connornishijima/Lixie_II_OSHW/README.md

Lixie II

# Lixie II Open Hardware
Want to make your own Lixie II? You're in the right place. This repository is a work in progress, but everything you need like the 3D printed base kit, Eagle PCB files or CAD files are here already!
