connornishijima/Lixie_II_OSHW/SOFTWARE/README.md

Software is located in its own repo, for Arduino reasons!

### [Lixie II Arduino Library](https://github.com/connornishijima/Lixie_II)
