connornishijima/Lixie_II_OSHW/3D PRINTING/LIXIE_CAP_SOLID.stl

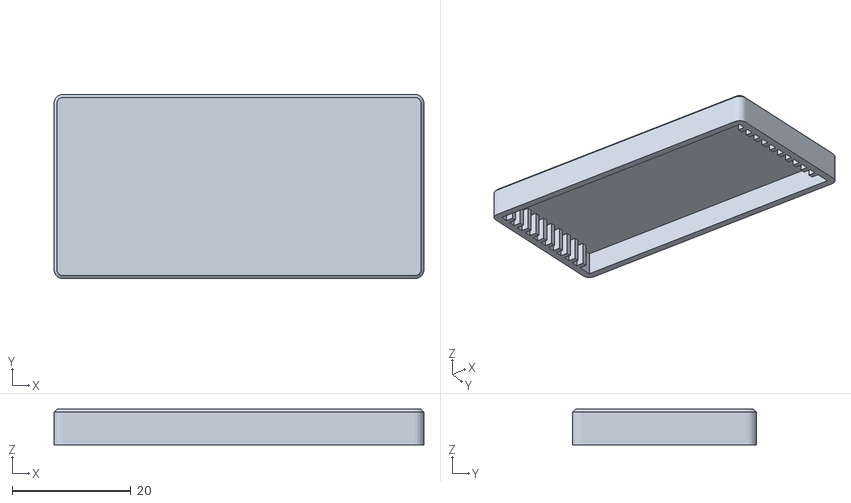
[picture p1: CAD file, 2020-10-05]
3D PRINTING/LIXIE_CAP_SOLID.stl
62.3 x 31.0 x 6.00
