connornishijima/Lixie_II_OSHW/3D PRINTING/LIXIE_II_BASE_LEFT.stl

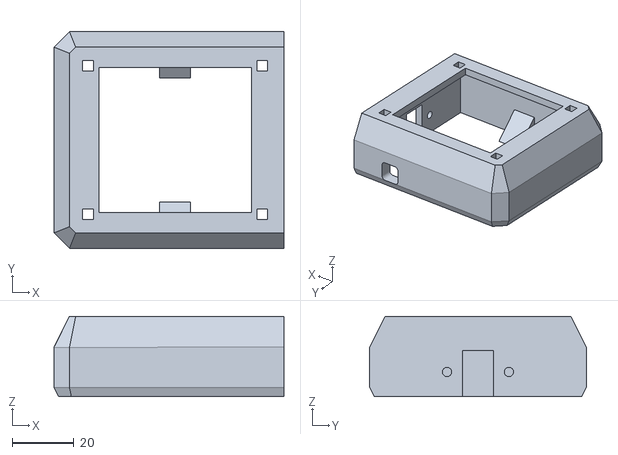
[picture p2: CAD file, 2019-11-22]
3D PRINTING/LIXIE_II_BASE_LEFT.stl
74.3 x 70.0 x 26.0
