connornishijima/Lixie_II_OSHW/3D PRINTING/LIXIE_II_BASE_MIDDLE.stl

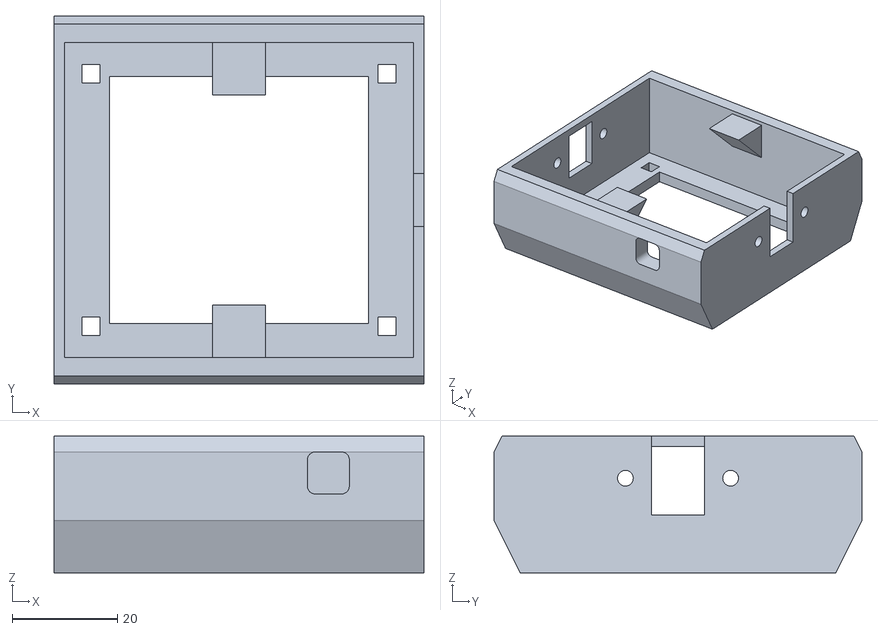
[picture p3: CAD file, 2019-11-22]
3D PRINTING/LIXIE_II_BASE_MIDDLE.stl
70.3 x 70.0 x 26.0
