connornishijima/Lixie_II_OSHW/3D PRINTING/LIXIE_II_BASE_RIGHT_CAP.stl

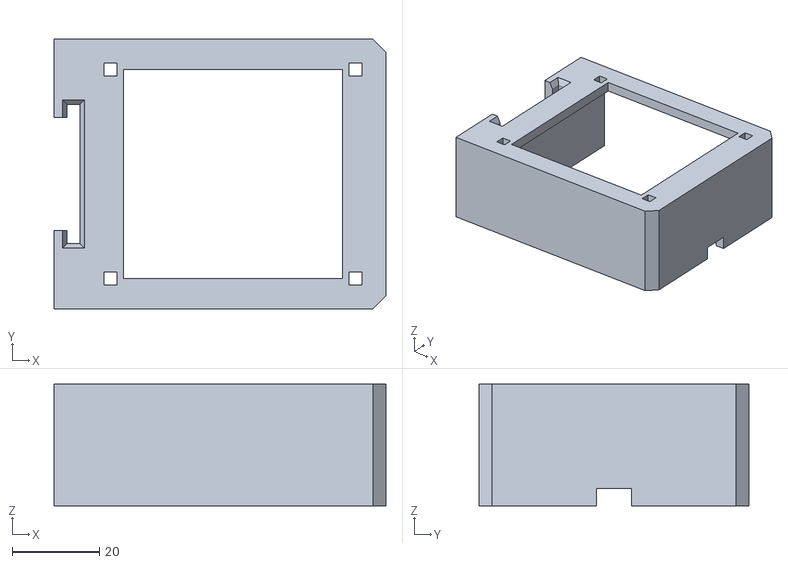
[picture p4: CAD file, 2019-08-13]
3D PRINTING/LIXIE_II_BASE_RIGHT_CAP.stl
76.3 x 62.0 x 28.0
