connornishijima/Lixie_II_OSHW/3D PRINTING/OLD_VERSION/LIXIE_II_BASE_MIDDLE.stl

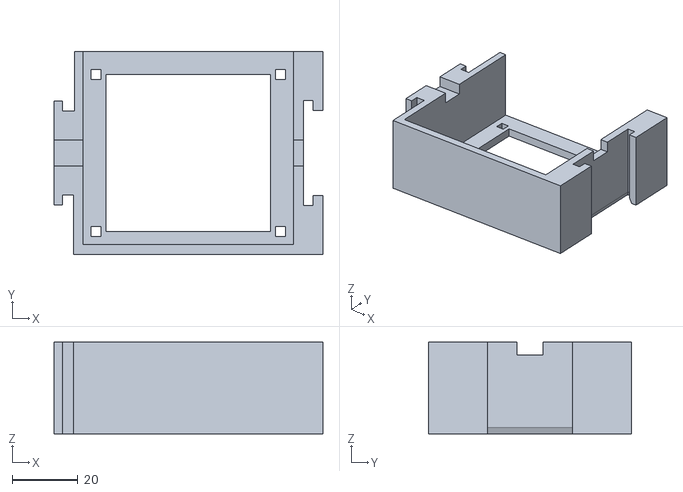
[picture p5: CAD file, 2019-08-13, an earlier design]
3D PRINTING/OLD_VERSION/LIXIE_II_BASE_MIDDLE.stl
82.1 x 62.0 x 28.0
