connornishijima/Lixie_II_OSHW/(list of files, cad)

Other CAD files:
3D PRINTING/LIXIE_II_BASE_RIGHT.stl
3D PRINTING/LIXIE_II_BASE_LEFT_CAP.stl
3D PRINTING/OLD_VERSION/LIXIE_II_BASE_LEFT_CAP.stl
