connornishijima/Lixie_II_OSHW/HARDWARE/PCB/LIXIE_II.brd

## EAGLE design HARDWARE/PCB/LIXIE_II.brd (2019-08-13)

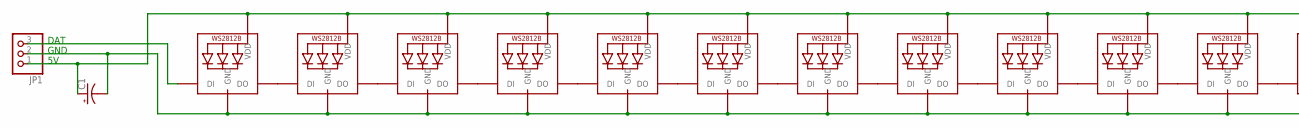
[picture p6: schematic LIXIE_II.sch, part in row 1, column 1]

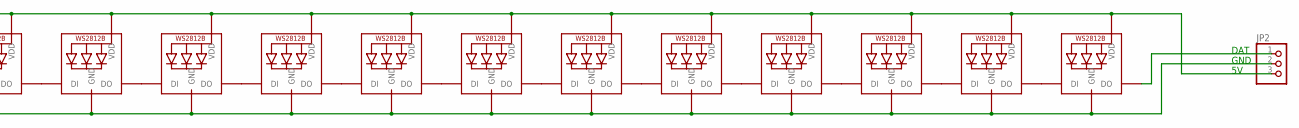
[picture p7: schematic LIXIE_II.sch, part in row 1, column 2]

Parts:
C1: CPOL-USE5-10.5; E5-10,5
JP1, JP2: PINHD-1X3; 1X03
LED1, LED2, LED3, LED4, LED5, LED6, LED7, LED8, LED9, LED10, LED11, LED12, LED13, LED14, LED15, LED16, LED17, LED18, LED19, LED20, LED21, LED22: WS2812B_5050N; WS2812B-NARROW

Connections:
5V: C1.+, JP1.1, JP2.3, LED1.1-VDD (VDD), LED2.1-VDD (VDD), LED3.1-VDD (VDD), LED4.1-VDD (VDD), LED5.1-VDD (VDD), LED6.1-VDD (VDD), LED7.1-VDD (VDD), LED8.1-VDD (VDD), LED9.1-VDD (VDD), LED10.1-VDD (VDD), LED11.1-VDD (VDD), LED12.1-VDD (VDD), LED13.1-VDD (VDD), LED14.1-VDD (VDD), LED15.1-VDD (VDD), LED16.1-VDD (VDD), LED17.1-VDD (VDD), LED18.1-VDD (VDD), LED19.1-VDD (VDD), LED20.1-VDD (VDD), LED21.1-VDD (VDD), LED22.1-VDD (VDD)
GND: C1.-, JP1.2, JP2.2, LED1.3-GND (GND), LED2.3-GND (GND), LED3.3-GND (GND), LED4.3-GND (GND), LED5.3-GND (GND), LED6.3-GND (GND), LED7.3-GND (GND), LED8.3-GND (GND), LED9.3-GND (GND), LED10.3-GND (GND), LED11.3-GND (GND), LED12.3-GND (GND), LED13.3-GND (GND), LED14.3-GND (GND), LED15.3-GND (GND), LED16.3-GND (GND), LED17.3-GND (GND), LED18.3-GND (GND), LED19.3-GND (GND), LED20.3-GND (GND), LED21.3-GND (GND), LED22.3-GND (GND)
unnamed: JP1.3, LED1.4-DIN (DI)
unnamed: LED1.2-DOUT (DO), LED2.4-DIN (DI)
unnamed: LED2.2-DOUT (DO), LED3.4-DIN (DI)
unnamed: LED3.2-DOUT (DO), LED4.4-DIN (DI)
unnamed: LED4.2-DOUT (DO), LED5.4-DIN (DI)
unnamed: LED5.2-DOUT (DO), LED6.4-DIN (DI)
unnamed: LED6.2-DOUT (DO), LED7.4-DIN (DI)
unnamed: LED7.2-DOUT (DO), LED8.4-DIN (DI)
unnamed: LED8.2-DOUT (DO), LED9.4-DIN (DI)
unnamed: LED9.2-DOUT (DO), LED10.4-DIN (DI)
unnamed: LED10.2-DOUT (DO), LED11.4-DIN (DI)
unnamed: LED11.2-DOUT (DO), LED12.4-DIN (DI)
unnamed: LED12.2-DOUT (DO), LED13.4-DIN (DI)
unnamed: LED13.2-DOUT (DO), LED14.4-DIN (DI)
unnamed: LED14.2-DOUT (DO), LED15.4-DIN (DI)
unnamed: LED15.2-DOUT (DO), LED16.4-DIN (DI)
unnamed: LED16.2-DOUT (DO), LED17.4-DIN (DI)
unnamed: LED17.2-DOUT (DO), LED18.4-DIN (DI)
unnamed: LED18.2-DOUT (DO), LED19.4-DIN (DI)
unnamed: LED19.2-DOUT (DO), LED20.4-DIN (DI)
unnamed: LED20.2-DOUT (DO), LED21.4-DIN (DI)
unnamed: LED21.2-DOUT (DO), LED22.4-DIN (DI)
unnamed: JP2.1, LED22.2-DOUT (DO)

Notes on the sheet:
DAT
GND

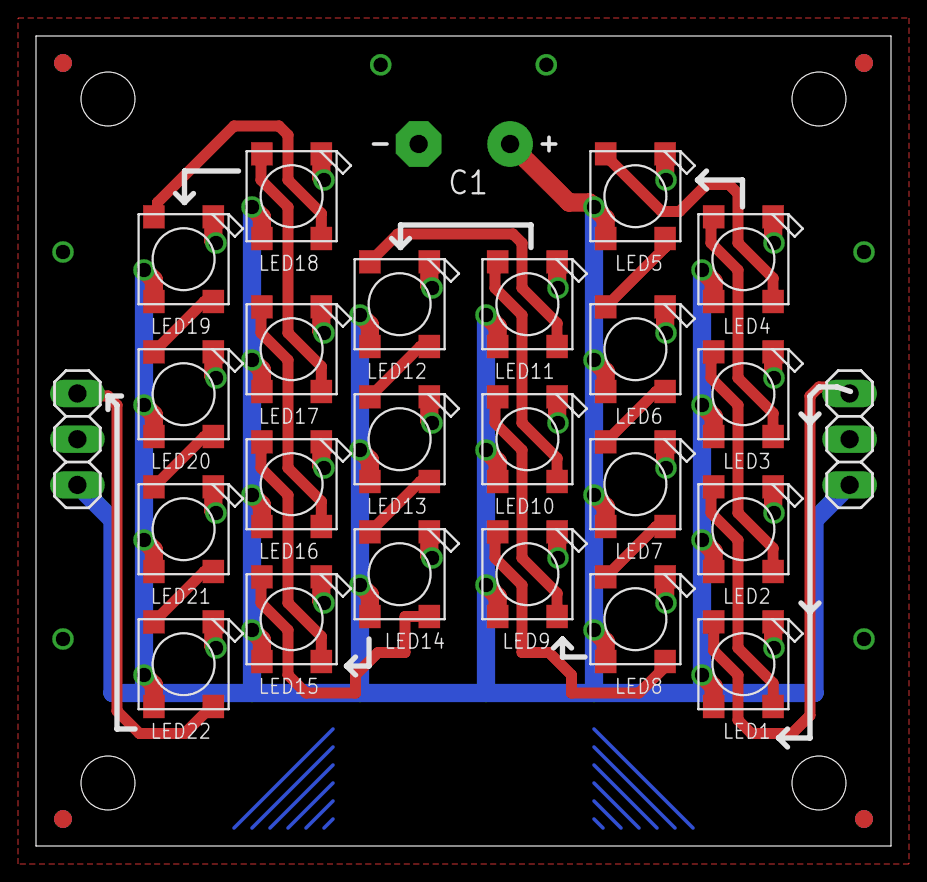
[picture p8: board LIXIE_II.brd from above]

Board: 2 copper layers, 47.5 x 45.0 mm, 29 parts (0 on the bottom side), 25 nets.

Other parts of the board:
U$1, U$2, U$3, U$4: CIRCLE-1MM-2R
