connornishijima/Lixie_II_OSHW/3D PRINTING/OLD_VERSION/readme.md

These are the original versions of the base kit that were released at launch. They do not support screw/nut pairing like the new system does.
