connornishijima/Lixie_II_OSHW/(threads)

Thread 1 (2019-08-19):

Few things missing

arturo182, 2019-08-19:
I'm looking into cutting and making my own Lixie II, and I noticed a few bits of information were hard to find or missing, would be nice to add them somewhere:

- I don't think it's specified anywhere how thick the MDF base should be (6mm)
- same for the light filter (1.5mm)
- there is no eps file for the light filter available?
- there is no BOM for the PCB
- it would be nice to have Gerber files for the PCB; not everyone has Eagle installed

Hopefully me complaining doesn't bring you down, it's still an awesome project, great work and thank you for making it OSHW!

vkhurana, 2019-11-13:
@arturo182 did you make any progress on making your own? I'm thinking of making one as well, and was curious if you got yours working.

DasWookie, 2019-11-26:
The base should be as thin as possible. I cut mine on my laser, but only because I didn't want to bother with firing up the 3D printer just for that as I was already using the laser for everything else.

You can 3D print the base and then paint it with something like a black paint to block light bleeding through to other panes. 1 or 2 layers would easily be enough.

You can generate the light filter from the CAD and export as DXF.

BOM for the PCB is 22 WS2811 RGB LEDs, 3 header pins (or however else you was to connect each board to one another and could be done just with soldered wires) and a 100uf capacitor. Pretty simple stuff. I used header pins and then created PCBs, and used 3-pin female headers to then interconnect each Lixie to the other.

Eagle is free. Install it. That's what I did. Took 5 minutes and I had the Gerber files exported, and I was off.

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

dorcu, 2020-10-09:
Do you have the controller PCB with wemos for the Lixie II?  I can't find it in this repository and there is only the old version.

Thread 2 (2019-11-25):

Can you provide the long base case stl file please!

scarrrr316, 2019-11-25:
can you provide the long base case （in the bellow photo） stl file, please
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

DasWookie, 2019-11-26:
I believe Connor used the 3 files he released in the files. They then snap together to form the single unit. Most printers don't have a large enough print area to be able to print the whole thing in one go, which is why I believe he split them into 3 parts (left, right, and center where you use as many center pieces as needed

DasWookie, 2019-11-26:
https://github.com/connornishijima/Lixie_II_OSHW/tree/master/3D%20PRINTING

scarrrr316, 2019-12-11:
> https://github.com/connornishijima/Lixie_II_OSHW/tree/master/3D%20PRINTING

thankyou, but I think that the long base in the picture is more beautiful than the short base that provided. if Connor does not send the long base STL file,  I just draw it by myself

scarrrr316, 2020-04-07:
ok.......I draw it myself

Closed 2020-04-07.
