connornishijima/Lixie_II_OSHW/(commit log)

2019-08-13 Added 3D printing STLs
    [LIXIE_II_BASE_LEFT_CAP.stl, LIXIE_II_BASE_MIDDLE.stl, LIXIE_II_BASE_RIGHT_CAP.stl]
2019-08-13 Added Assembly Instructions
2019-11-22 Updated to improved base design!
    [LIXIE_II_BASE_LEFT.stl, LIXIE_II_BASE_LEFT_CAP.stl, LIXIE_II_BASE_MIDDLE.stl, LIXIE_II_BASE_RIGHT.stl, LIXIE_II_BASE_RIGHT_CAP.stl]
2020-10-05 Added printable Lixie II Cap
    [LIXIE_CAP_SOLID.stl]
